enriquewph/esp32-ups-monitor/kicad.kicad_pcb

## KiCad design kicad.kicad_pcb (2022-06-27)

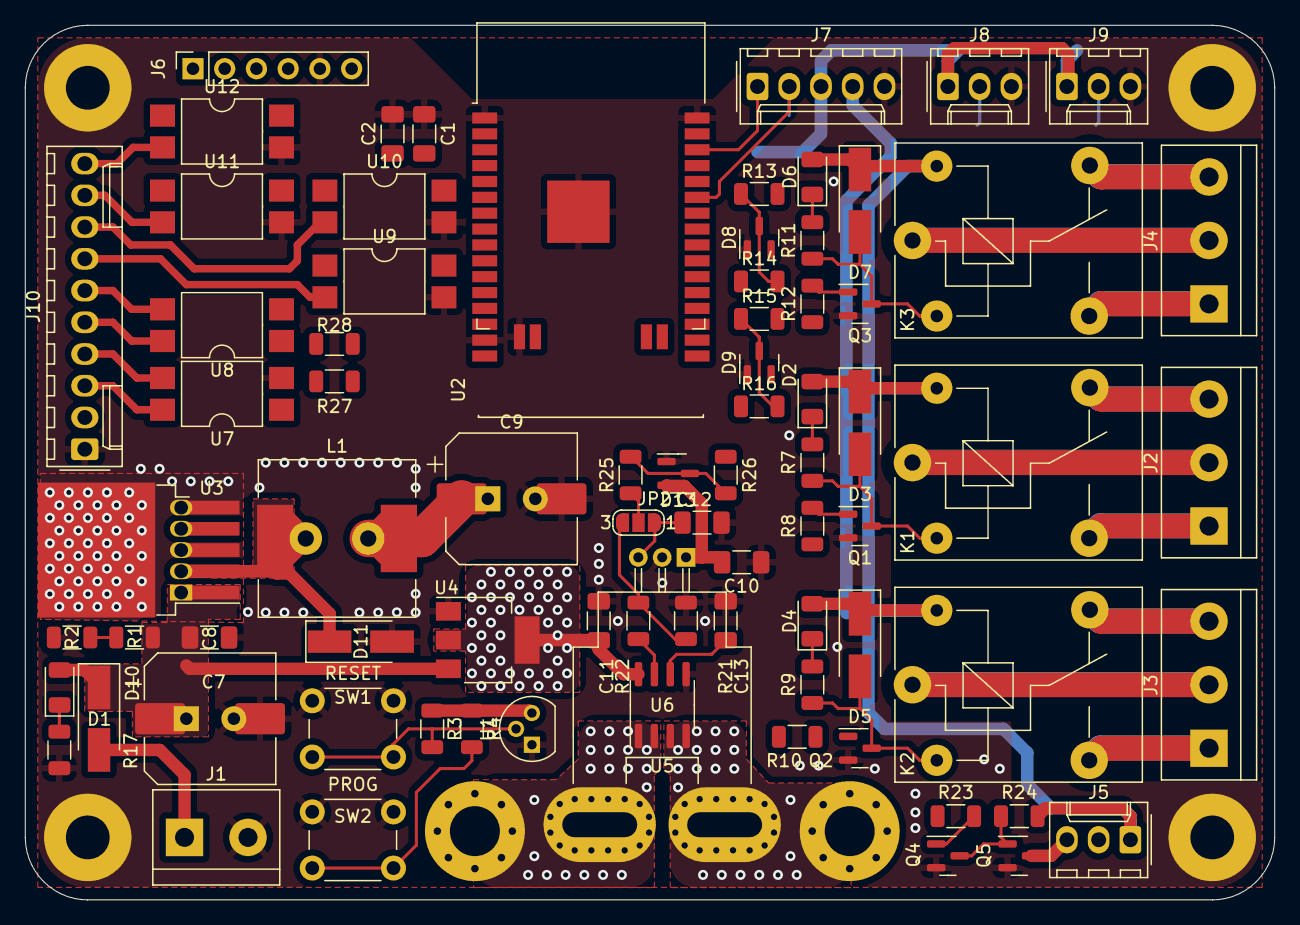
[picture p1: board kicad.kicad_pcb from above]

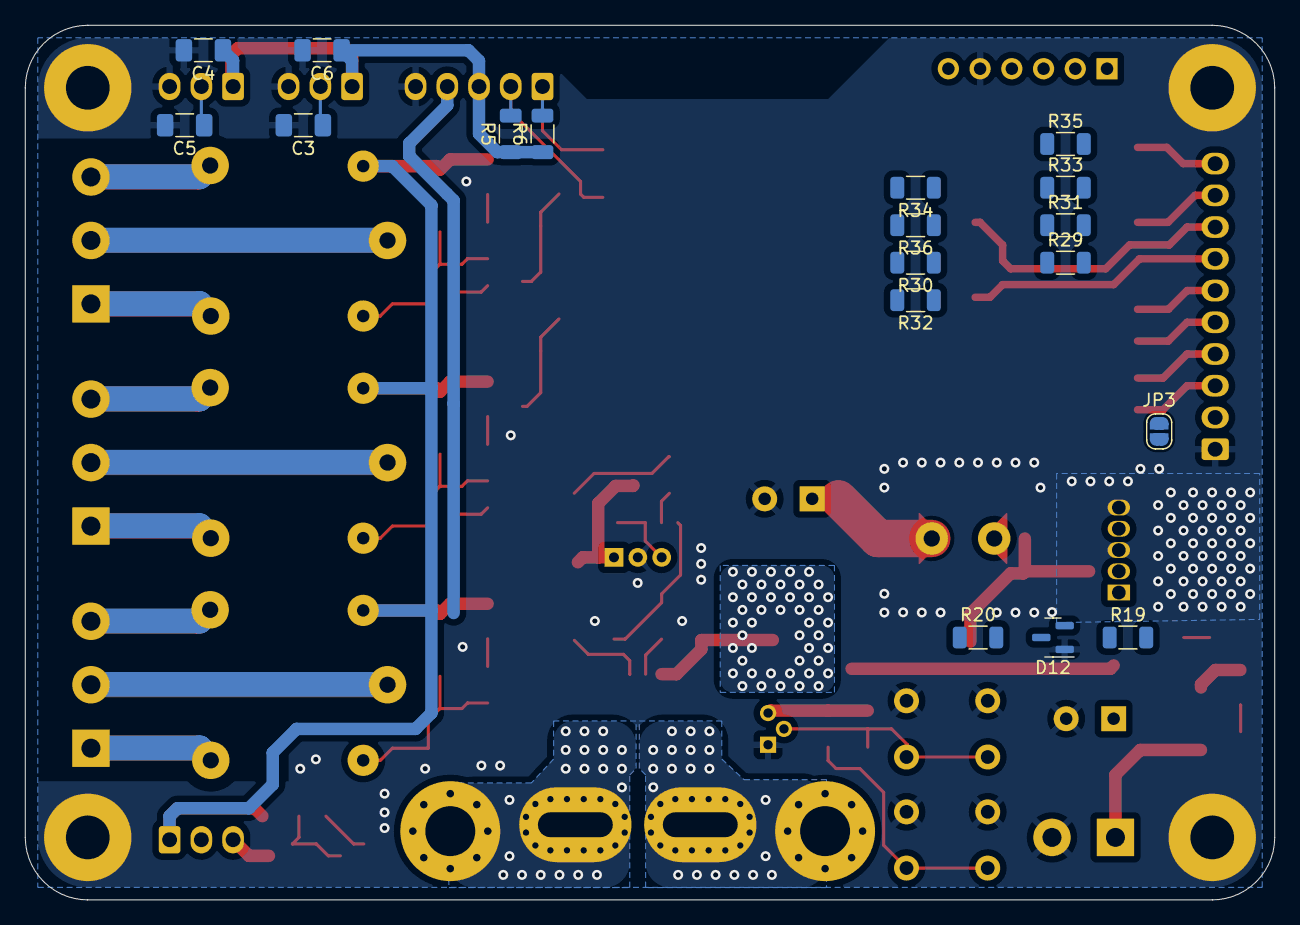
[picture p2: board kicad.kicad_pcb from below]

Board: 2 copper layers, 100.0 x 70.0 mm, 98 parts (18 on the bottom side), 77 nets.

Parts:
C1, C3, C4, C5, C6, C8, C10, C11, C12: 100nF; C_1206_3216Metric_Pad1.33x1.80mm_HandSolder
C2: 1uF; C_1206_3216Metric_Pad1.33x1.80mm_HandSolder
C7, C9: 470uF; CAP_10x10_SMD_THT
C13: 1nF; C_1206_3216Metric_Pad1.33x1.80mm_HandSolder
D1, D11: SS14; D_SMA_Handsoldering
D2, D4, D6, D10: LED; LED_1206_3216Metric
D3, D5, D7: M7; D_SMA_Handsoldering
D8, D9, D12, D13: BAT54S; SOT-23
H1, H2: MountingHole_Pad; MountingHole_4mm_Pad_Via
J1: Screw_Terminal_01x02; TerminalBlock_bornier-2_P5.08mm
J2, J3, J4: Screw_Terminal_01x03; TerminalBlock_bornier-3_P5.08mm
J5, J8, J9: Conn_01x03; Molex_KK-254_AE-6410-03A_1x03_P2.54mm_Vertical
J6: ICSP; PinSocket_1x06_P2.54mm_Vertical
J7: Conn_01x05; Molex_KK-254_AE-6410-05A_1x05_P2.54mm_Vertical
J10: Conn_01x10; Molex_KK-254_AE-6410-10A_1x10_P2.54mm_Vertical
JP2: SolderJumper_3_Bridged12; SolderJumper-3_P1.3mm_Open_RoundedPad1.0x1.5mm_NumberLabels
JP3: SolderJumper_2_Open; SolderJumper-2_P1.3mm_Open_RoundedPad1.0x1.5mm
K1, K2, K3: RELAY; Relay_SPDT_SANYOU_SRD_Series_Form_C
L1: 68uH; L_12x12mm_H8mm
Q1, Q2, Q3, Q4: BC817; SOT-23
Q5: IRLML2502; SOT-23
R1: 22k; R_1206_3216Metric
R2: 5k6; R_1206_3216Metric
R3, R4, R5, R6, R24, R30, R32, R34, R36: 10k; R_1206_3216Metric
R7, R8, R9, R10, R11, R12, R13, R14, R15, R16, R17, R19, R20, R22, R23, R25, R26, R29, R31, R33, R35: 1k; R_1206_3216Metric
R21: 2k; R_1206_3216Metric
R27, R28: 100; R_1206_3216Metric
SW1, SW2: SW_Push; SW_PUSH_6mm
U1: DS1233A-10; TO-92
U2: ESP32; ESP32-WROOM-WROVER-NC
U3: LM2596S-3.3; TO-263-5_TabPin3
U4: AMS1117-5.0; SOT-223-3_TabPin2
U5: ACS759; Allegro_CB_PFF
U6: ACS712; SOIC-8_3.9x4.9mm_P1.27mm
U7, U8, U9, U10, U11, U12: PC817XI; SMDIP-4_W9.53mm

Connections:
+3V3: C1.1, C2.1, C4.1, C6.1, C9.1, C10.1, D8.2, D9.2, D12.2, D13.2, J6.6, J7.3, J8.1, J9.1, L1.2, R3.1, R4.1, R5.1, R6.1, R30.1, R32.1, R34.1, R36.1, U1.3 (VDD), U2.2 (VDD), U3.4 (FB), U5.1 (VCC), U8.1
+5V: C11.1, J7.4, U4.2 (VO), U6.8 (VCC)
+12V: C7.1, C8.1, D1.1 (K), D2.2 (A), D3.1 (K), D4.2 (A), D5.1 (K), D6.2 (A), D7.1 (K), D10.2 (A), J5.1, JP3.2 (B), K1.5, K2.5, K3.5, R1.1, R24.1, U3.1 (VIN), U4.3 (VI)
+BATT: D1.2 (A), J1.1
/Current Sensor/IP+: H1.1, U5.4 (IP+), U6.1 (IP+), U6.2 (IP+)
/Current Sensor/IP-: H2.1, U5.5 (IP-), U6.3 (IP-), U6.4 (IP-)
/Current Sensor/OUT: JP2.2 (C), R25.2
/Input Protection/IN: R1.2, R2.1, R19.2
/LM35: T1/OUT: C3.1, J8.2, R13.2
/LM35: T2/OUT: C5.1, J9.2, R15.2
/Opto I/O/input-0/A: J10.2, JP3.1 (A), R29.2, R31.2, R33.2, R35.2
/Opto I/O/input-0/K: J10.7, U9.2
/Opto I/O/input-1/K: J10.8, U10.2
/Opto I/O/input-2/K: J10.9, U11.2
/Opto I/O/input-3/K: J10.10, U12.2
/Opto I/O/output-0/C: J10.5, U8.4
/Opto I/O/output-0/E: J10.6, U8.3
/Opto I/O/output-1/C: J10.3, U7.4
/Opto I/O/output-1/E: J10.4, U7.3
/Relay 1/COM: J2.2, K1.1
/Relay 1/NC: J2.3, K1.4
/Relay 1/NO: J2.1, K1.3
/Relay 2/COM: J3.2, K2.1
/Relay 2/NC: J3.3, K2.4
/Relay 2/NO: J3.1, K2.3
/Relay 3/COM: J4.2, K3.1
/Relay 3/NC: J4.3, K3.4
/Relay 3/NO: J4.1, K3.3
/Salida MOSFET/OUT: J5.3, Q5.3 (D)
FAN_1: R23.2, U2.26 (IO4)
GND: C1.2, C2.2, C3.2, C4.2, C5.2, C6.2, C7.2, C8.2, C9.2, C10.2, C11.2, C12.2, C13.2, D8.1, D9.1, D11.2 (A), D12.1, D13.1, J1.2, J6.5, J7.5, J8.3, J9.3, J10.1, Q1.2 (E), Q2.2 (E), Q3.2 (E), Q4.2 (E), Q5.2 (S), R2.2, R17.2, R21.1, SW1.1, SW2.1, U1.1 (GND), U2.1 (GND), U2.15 (GND), U2.38 (GND), U2.39 (GND), U3.3 (GND), U3.5 (~ON/OFF), U4.1 (GND), U5.2 (GND), U6.5 (GND), U7.2, U9.3, U10.3, U11.3, U12.3
GPIO0: J6.4, R4.2, SW2.2, U2.25 (IO0)
IBAT: R26.1, U2.6 (IO34)
IN0: R30.2, U2.10 (IO25), U9.4
IN1: R32.2, U2.11 (IO26), U10.4
IN2: R34.2, U2.8 (IO32), U11.4
IN3: R36.2, U2.9 (IO33), U12.4
unnamed: C12.1, JP2.1 (A), U5.3 (VIOUT)
unnamed: C13.1, U6.6 (FILTER)
unnamed: D2.1 (K), R7.1
unnamed: D3.2 (A), K1.2, Q1.3 (C), R7.2
unnamed: D4.1 (K), R9.1
unnamed: D5.2 (A), K2.2, Q2.3 (C), R9.2
unnamed: D6.1 (K), R11.1
unnamed: D7.2 (A), K3.2, Q3.3 (C), R11.2
unnamed: D8.3, R13.1, R14.2
unnamed: D9.3, R15.1, R16.2
unnamed: D10.1 (K), R17.1
unnamed: D11.1 (K), L1.1, U3.2 (OUT)
unnamed: D12.3, R19.1, R20.2
unnamed: D13.3, R25.1, R26.2
unnamed: JP2.3 (B), R21.2, R22.1
unnamed: Q1.1 (B), R8.1
unnamed: Q2.1 (B), R10.1
unnamed: Q3.1 (B), R12.1
unnamed: Q4.1 (B), R23.1
unnamed: Q4.3 (C), Q5.1 (G), R24.2
unnamed: R22.2, U6.7 (VIOUT)
unnamed: R27.1, U7.1
unnamed: R28.1, U8.2
unnamed: R29.1, U9.1
unnamed: R31.1, U10.1
unnamed: R33.1, U11.1
unnamed: R35.1, U12.1
OUT0: R28.2, U2.30 (IO18)
OUT1: R27.2, U2.31 (IO19)
RELAY_1: R8.2, U2.16 (IO13)
RELAY_2: R10.2, U2.12 (IO27)
RELAY_3: R12.2, U2.37 (IO23)
RESET: J6.1, R3.2, SW1.2, U1.2 (~RESET), U2.3 (EN)
RXD0: J6.3, U2.34 (RXD0/IO3)
SCL: J7.1, R6.2, U2.36 (IO22)
SDA: J7.2, R5.2, U2.33 (IO21)
TBAT: R14.1, U2.5 (SENSOR_VN)
TEMP2: R16.1, U2.7 (IO35)
TXD0: J6.2, U2.35 (TXD0/IO1)
VBAT: R20.1, U2.4 (SENSOR_VP)
