enriquewph/esp32-ups-monitor/(threads)

Thread 17 (2021-06-11):

add programing header for esp32

enriquewph, 2021-06-11:

enriquewph, 2021-06-27:
Se va a usar este conversor, el FT232
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

Pero se debe modificar, y agregar 2 transistores como en el sch original para que quede:

 - EN
 - RX (TX DEL ESP32)
 - TX (RX DEL ESP32)
 - IO0
 - GND
 - 3.3v

Closed 2021-06-27.

Thread 20 (2021-06-13):

Entrada para sensor de corriente inductivo 100A

enriquewph, 2021-06-13:

enriquewph, 2021-06-25:
Se va a usar el sensor:
sct-013-100
tiene entrada en formato PLUG 3.5MM.

Info: https://www.poweruc.pl/blogs/news/non-invasive-sensor-yhdc-sct013-000-ct-used-with-arduino-sct-013

Hay que implementarle un FILTRO PASA BAJOS, con corte en 50Hz

enriquewph, 2021-06-25:
Tambien se podria implementar alguna amplificación con un OPAMP, o usar un ADC de 16 bits para su lectura.

enriquewph, 2021-06-25:
El adc a implementar, posiblemente puede ser el ADS1115
https://articulo.mercadolibre.com.ar/MLA-754926739-conversor-analogico-a-digital-adc-ads1115ads1015-16bit-i2c-_JM
Tiene:
- Internal Low-Drift Voltage Reference
- Programmable Data Rate: 8 SPS to 860 SPS
- Wide Supply Range: 2.0 V to 5.5 V
- Low Current Consumption: 150 μA
- I2C Interface: Four Pin-Selectable Addresses

enriquewph, 2021-06-25:
Cumple con el minimo de 600 Samples/s para medir correctamente la onda senoidal.

enriquewph, 2021-06-25:
Estableciendo para medir una corriente pico para:
~15KW -> 220v   65A

Esto otorgaría una salida de 0.65V, lo que es insuficiente. Hay que amplificarlo 2x, o darle mas vueltas al bobinado primario.

2 vueltas: 65A -> 1.3V
3 vueltas: 65A -> 1.95V

El ADC mide hasta +-2.048V asique se tienen que hacer de 2 a 3 vueltas para un resultado optimo.

enriquewph, 2021-06-25:
combinar #25 para seguir aca.

enriquewph, 2021-06-25:
La otra entrada del adc la podemos aprovechar, con un transformador de 220v a 12v o algo similar, para medir la tensión de red.

No escatimar en protecciones a las entradas.

Thread 32 (2021-06-27):

Add ethernet & GPIO Expander

enriquewph, 2021-06-27:
Opción buena:
MCP23016 (16 bits)

sino buscar alguno barato en gugel

enriquewph, 2021-06-28:
Se va a usar el Pcf8574 que es mas barato.
http://tienda.ityt.com.ar/sin-catalogar/5454-pcf8574-pcf8574a-pcf8574at-i-o-expansion-i2c-8-lineas-soic16-itytarg.html
