enriquewph/esp32-ups-monitor/(commit log)

2021-06-07 add kicad files
    [inprot.sch, kicad.kicad_pcb, kicad.sch, psu.sch]
2021-06-08 Several changes.
    [currentsensor.sch, inprot.sch, kicad.sch, lm35.sch, mosfet-out.sch, opto-in.sch, opto-out.sch, opto.sch]
2021-06-10 Full update to psu.sch
    [psu.sch]
2021-06-10 updated all components
    [currentsensor.sch, inprot.sch, kicad.sch, lm35.sch, mosfet-out.sch, opto-in.sch, opto-out.sch, opto.sch]
2021-06-10 various updates
    [currentsensor.sch, inprot.sch, kicad.kicad_pcb, kicad.sch, opto-in.sch, psu.sch, relay.sch]
2021-06-10 change layout
    [currentsensor.sch, inprot.sch, kicad.sch, lm35.sch, mosfet-out.sch, opto-in.sch, opto-out.sch, opto.sch]
2021-06-26 new footprints
    [serialport.sch]
2021-06-26 More footprints
2021-06-27 more footprints & 3d models
    [currentsensor.sch, inprot.sch, kicad.kicad_pcb, kicad.sch, lm35.sch, opto-in.sch, psu.sch, relay.sch]
2021-06-27 Closes #17
    [inprot.sch, lm35.sch, opto-in.sch, relay.sch, serialport.sch]
2021-06-27 Closes #13
    [inprot.sch, kicad.sch]
2021-06-27 Closes #14
    [inprot.sch, kicad.sch, mosfet-out.sch]
2021-06-27 Closes #18
    [currentsensor.sch]
2021-06-27 Several changes
    Usando stock de http://tienda.ityt.com.ar/
    [currentsensor.sch, inprot.sch, kicad.kicad_pcb, kicad.sch, lm35.sch, mosfet-out.sch, opto-in.sch, opto-out.sch]
2021-06-28 Closes #29
    [currentsensor.sch, inprot.sch, io.sch, kicad.kicad_pcb, kicad.sch, lm35.sch, mosfet-out.sch, opto-in.sch]
2022-06-26 routeo fase 1
    [currentsensor.kicad_sch, inprot.kicad_sch, io.kicad_sch, kicad.kicad_pcb, kicad.kicad_sch, lm35.kicad_sch, mosfet-out.kicad_sch, opto-in.kicad_sch]
2022-06-26 fix bugardo
    [io.kicad_sch, kicad.kicad_pcb, kicad.kicad_sch]
2022-06-26 fix bugardo - update design rules
    [kicad.kicad_pcb]
2022-06-27 fix bugardo - routeos principales
    [kicad.kicad_pcb]
